mappingvermont/burlington-bike-counter/display/README.md

# Display Unit — Matrix Portal S3

The display unit receives BLE advertisements from the sensor unit and renders the running bike count as large amber digits on a black background.

- **[electronics.md](electronics.md)** — Matrix Portal S3, 64×32 RGB panel, power bank, wiring, and firmware
- **[enclosure.md](enclosure.md)** — waterproof, tamper-resistant PVC enclosure
