mappingvermont/burlington-bike-counter/display/enclosure.md

# Display Enclosure

Waterproof, tamper-resistant PVC enclosure for the 64×32 RGB LED panel (Matrix Portal ESP32-S3).

## Dimensions

- Interior: 15.2" x 7.5" x 2.5" (panel + Matrix Portal + power bank)
- Frame wall thickness: 3/4" (1x4 boards)
- Rear panel thickness: 1/2"
- Exterior: 17" x 9" x 3.5"

## Components

### Structure
- PVC 1x4 boards (top, bottom, two sides)
- PVC 1/2" sheet (rear panel, cut to 17" x 9")
- Polycarbonate sheet (front window, already have)

### Joints
- PVC cement — top, bottom, and permanent side to rear panel
- Screws in side panel only, resealed with silicone each time

### Mounting
- Eyebolts through rear panel + zip ties around fence rails (stabilization)
- Long shackle padlock through hasp staple, looped around fence rail

### Sealing
- Silicone caulk — all seams, corners, front window perimeter, access panel
- Silica gel desiccant inside

### Tamper Resistance
- Hasp on rear panel, long shackle padlock through hasp staple and around fence rail — prevents removal

## Assembly Notes

- Pre-drill all holes before screwing
- Use stainless or coated screws for anything exposed
- Leave ~1cm airspace between LED panel and box walls (heat)
- Countersink screw holes so heads sit flush

## Bill of Materials

| Item | Qty | Source | Link | Price | Notes |
|---|-----|---|---|---|---|
| PVC 1x4 x 8ft | 1 | Lowe's | [5013353133](https://www.lowes.com/pd/Metrie-PVC-Trim-Board-3-4-In-x-3-1-2-In-x-8-Ft/5013353133) | $20.00 | Top, bottom, two sides |
| PVC sheet, 1/2" x 24" x 4ft | 1 | Lowe's | [5014750403](https://www.lowes.com/pd/RELIABILT-0-5-in-x-24-in-x-4-ft-Reversible-Smooth-Wood-Grain-PVC-Trim-Board/5014750403) | $40.00 | Rear panel, cut to 17" x 9" |
| PVC primer and cement | 1 can | Lowe's | — | $12.00 | Permanent joints |
| Silicone caulk (clear or white) | 1 tube | Lowe's | — | | All seams + front window |
| Eyebolts (stainless) | 2 | Lowe's | — | | Rear panel, stabilize against fence |
| Hasp + staple (stainless) | 1 | Lowe's | — | $11.00 | Rear panel |
| Long shackle padlock | 1 | Lowe's | — | | Through hasp staple, around fence rail |
| Waterproof USB-C panel mount, IP67 | 1 | Amazon | [B09QLR3ZG6](https://www.amazon.com/ANMBEST-Mounting-Waterproof-Connector-PA6BG33/dp/B09QLR3ZG6) | | Bottom of enclosure, charging port |
| Silica gel desiccant packets | 2–3 | Amazon | [B0CGHY9VWC](https://www.amazon.com/gp/product/B0CGHY9VWC/) | | Inside display enclosure |
| Polycarbonate sheet | 1 | Lowe's | — | | Front window |
