mappingvermont/burlington-bike-counter/(commit log)

2026-06-06 current status
2026-06-06 RTC board working, fix connection drop, tweak display
    [code.py, phase2.ino]
2026-06-08 display enclosure research
2026-06-08 maybe we hide the sensor box in vegetation
2026-06-08 update next steps to capture latest enclosure notes
2026-06-29 fix numbers to match flipped display
    [code.py]
2026-07-27 configure CircuitPython web workflow
2026-07-27 add circuit python Web Workflow connection
2026-08-01 dim green to decrease display power consumption yikes
2026-08-02 troubleshooting blank display with battery at 91%
2026-08-03 add trial data from day 1 and day 2
    [20260801.csv, 20260802.csv]
